henrides/bench_psu/kicad/sim/INA180A1 Test Circuit-PSpiceFiles/SCHEMATIC1/TRANSIENT/TRANSIENT.cir

** Profile: "SCHEMATIC1-TRANSIENT"  [ C:\Macromodels\PSpice Library\^INA180\INA180A1_PSpice\ina180a1 test circuit-pspicefiles\schematic1\transient.sim ] 

** Creating circuit file "TRANSIENT.cir" 
** WARNING: THIS AUTOMATICALLY GENERATED FILE MAY BE OVERWRITTEN BY SUBSEQUENT SIMULATIONS

*Libraries: 
* Profile Libraries :
* Local Libraries :
.LIB "../../../ina180a1.lib" 
* From [PSPICE NETLIST] section of C:\Users\a0282827\AppData\Roaming\SPB_Data\cdssetup\OrCAD_PSpice/16.6.0/PSpice.ini file:
.lib "nom.lib" 

*Analysis directives: 
.TRAN  0 300u 0 300n 
.OPTIONS ADVCONV
.PROBE64 V(alias(*)) I(alias(*)) W(alias(*)) D(alias(*)) NOISE(alias(*)) 
.INC "..\SCHEMATIC1.net" 


.END
