henrides/bench_psu/(list of files, drawings)

Other design files:
kicad/sim/INA180_PSPICE_AIO_16AUG2019.bak/INA180.DSN
kicad/sim/INA180_PSPICE_AIO_16AUG2019.bak/ina180.opj
kicad/sim/ina180a1 test circuit.dsn
kicad/sim/ina180a1 test circuit.opj
