henrides/bench_psu/kicad/Regulation/Regulation.kicad_pcb

## KiCad design kicad/Regulation/Regulation.kicad_pcb (2025-05-29)

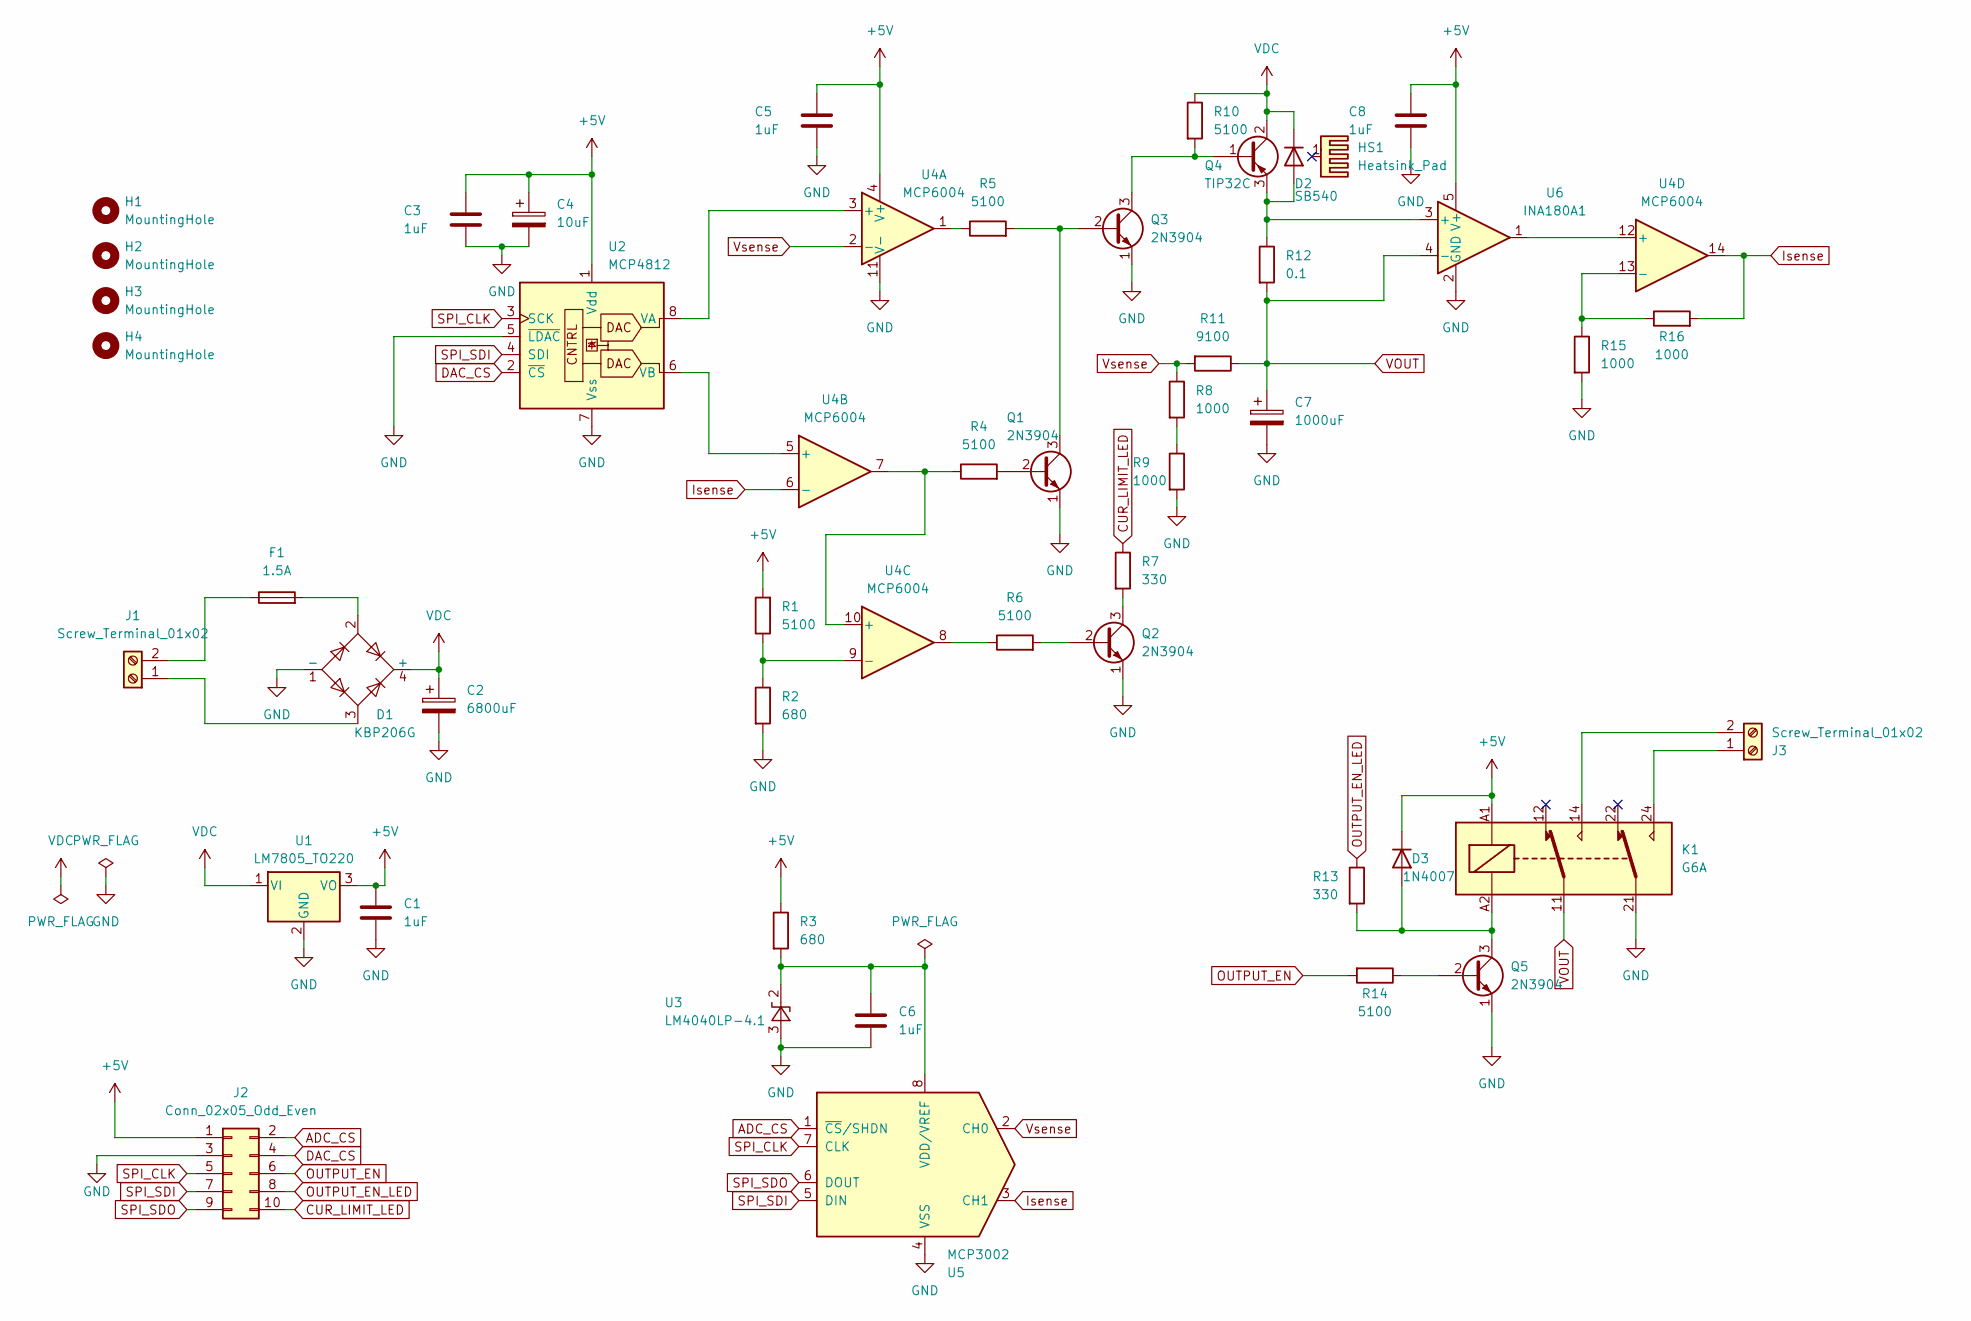
[picture p1: schematic Regulation.kicad_sch, PSU - Regulation]

Parts:
C1, C3, C5, C6, C8: 1uF; C_0805_2012Metric
C2: 6800uF; CP_Radial_D18.0mm_P7.50mm
C4: 10uF; CP_EIA-3216-18_Kemet-A_Pad1.58x1.35mm_HandSolder
C7: 1000uF; CP_Radial_D12.5mm_P5.00mm
D1: KBP206G; Diode_THT_Diode_Bridge_SIP365W86P406L1475H1060Q4
D2: SB540; D_DO-201AD_P12.70mm_Horizontal
D3: 1N4007; D_DO-41_SOD81_P7.62mm_Horizontal
F1: 1.5A; Fuseholder_Clip-6.3x32mm_Littelfuse_102_122_Inline_P34.21x7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
H1, H2, H3, H4: MountingHole; MountingHole_3.2mm_M3
HS1: Heatsink_Pad; Heatsink_Fischer_SK129-STS_42x25mm_2xDrill2.5mm
J1, J3: Screw_Terminal_01x02; TerminalBlock_RND_205-00012_1x02_P5.00mm_Horizontal
J2: Conn_02x05_Odd_Even; PinSocket_2x05_P2.54mm_Vertical
K1: G6A; Relay_DPDT_Omron_G6A
Q1, Q2, Q3, Q5: 2N3904; TO-92_Inline_Wide
Q4: TIP32C; TO-220-3_Vertical
R1, R4, R5, R6, R10, R14: 5100; R_0805_2012Metric
R2, R3: 680; R_0805_2012Metric
R7, R13: 330; R_0805_2012Metric
R8, R9, R15, R16: 1000; R_0805_2012Metric
R11: 9100; R_0805_2012Metric
R12: 0.1; R_Bare_Metal_Element_L16.3mm_W4.0mm_no_mask
U1: LM7805_TO220; TO-220-3_Vertical
U2: MCP4812; DIP-8_W7.62mm
U3: LM4040LP-4.1; TO-92_Inline
U4: MCP6004; DIP-14_W7.62mm
U5: MCP3002; DIP-8_W7.62mm
U6: INA180A1; SOT-23-5_HandSoldering

Connections:
+5V: C1.1, C3.1, C4.1, C5.1, C8.1, D3.1 (K), J2.1, K1.A1, R1.2, R3.1, U1.3 (VO), U2.1 (Vdd), U4.4 (V+), U6.5 (V+)
ADC_CS: J2.2, U5.1 (~CS/SHDN)
CUR_LIMIT_LED: J2.10, R7.1
DAC_CS: J2.4, U2.2 (~CS)
GND: C1.2, C2.2, C3.2, C4.2, C5.2, C6.2, C7.2, C8.2, D1.1 (-), J2.3, K1.21, Q1.1 (E), Q2.1 (E), Q3.1 (E), Q5.1 (E), R2.2, R9.2, R15.2, U1.2 (GND), U2.5 (~LDAC), U2.7 (Vss), U3.3 (A), U4.11 (V-), U5.4 (VSS), U6.2 (GND)
Isense: R16.2, U4.6 (-), U4.14, U5.3 (CH1)
unnamed: D1.2, F1.2
unnamed: D2.2 (A), Q4.3 (E), R12.1, U6.3 (+)
unnamed: D3.2 (A), K1.A2, Q5.3 (C), R13.2
unnamed: D1.3, J1.1
unnamed: F1.1, J1.2
unnamed: J3.1, K1.24
unnamed: J3.2, K1.14
unnamed: Q1.2 (B), R4.2
unnamed: Q1.3 (C), Q3.2 (B), R5.2
unnamed: Q2.2 (B), R6.2
unnamed: Q2.3 (C), R7.2
unnamed: Q3.3 (C), Q4.1 (B), R10.2
unnamed: Q5.2 (B), R14.1
unnamed: R5.1, U4.1
unnamed: R6.1, U4.8
unnamed: R8.2, R9.1
unnamed: U2.8 (VA), U4.3 (+)
unnamed: U2.6 (VB), U4.5 (+)
unnamed: C6.1, R3.2, U3.2 (K), U5.8 (VDD/VREF)
unnamed: R4.1, U4.7, U4.10 (+)
unnamed: R1.1, R2.1, U4.9 (-)
unnamed: U4.12 (+), U6.1
unnamed: R15.1, R16.1, U4.13 (-)
OUTPUT_EN: J2.6, R14.2
OUTPUT_EN_LED: J2.8, R13.1
SPI_CLK: J2.5, U2.3 (SCK), U5.7 (CLK)
SPI_SDI: J2.7, U2.4 (SDI), U5.5 (DIN)
SPI_SDO: J2.9, U5.6 (DOUT)
VDC: C2.1, D1.4 (+), D2.1 (K), Q4.2 (C), R10.1, U1.1 (VI)
VOUT: C7.1, K1.11, R11.1, R12.2, U6.4 (-)
Vsense: R8.1, R11.2, U4.2 (-), U5.2 (CH0)

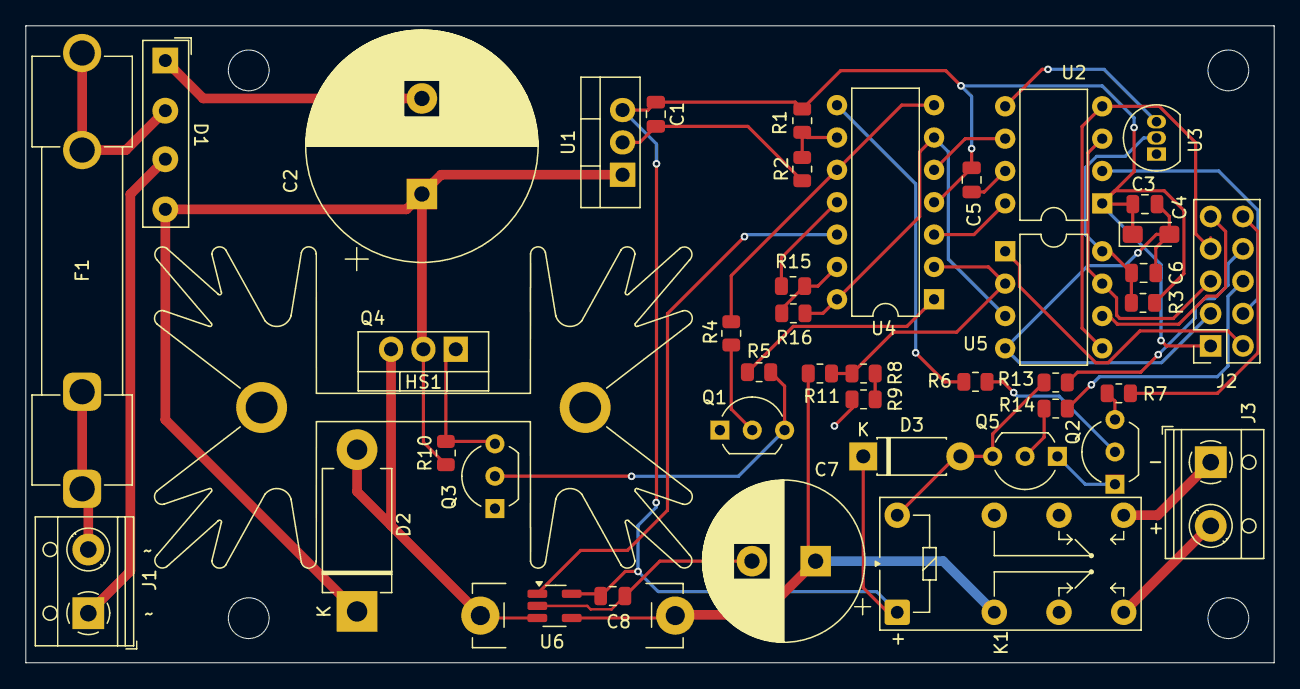
[picture p2: board Regulation.kicad_pcb from above]

Board: 2 copper layers, 98.0 x 50.0 mm, 48 parts (0 on the bottom side), 37 nets.
