henrides/bench_psu/kicad/Control/Control.kicad_pcb

## KiCad design kicad/Control/Control.kicad_pcb (2025-05-29)

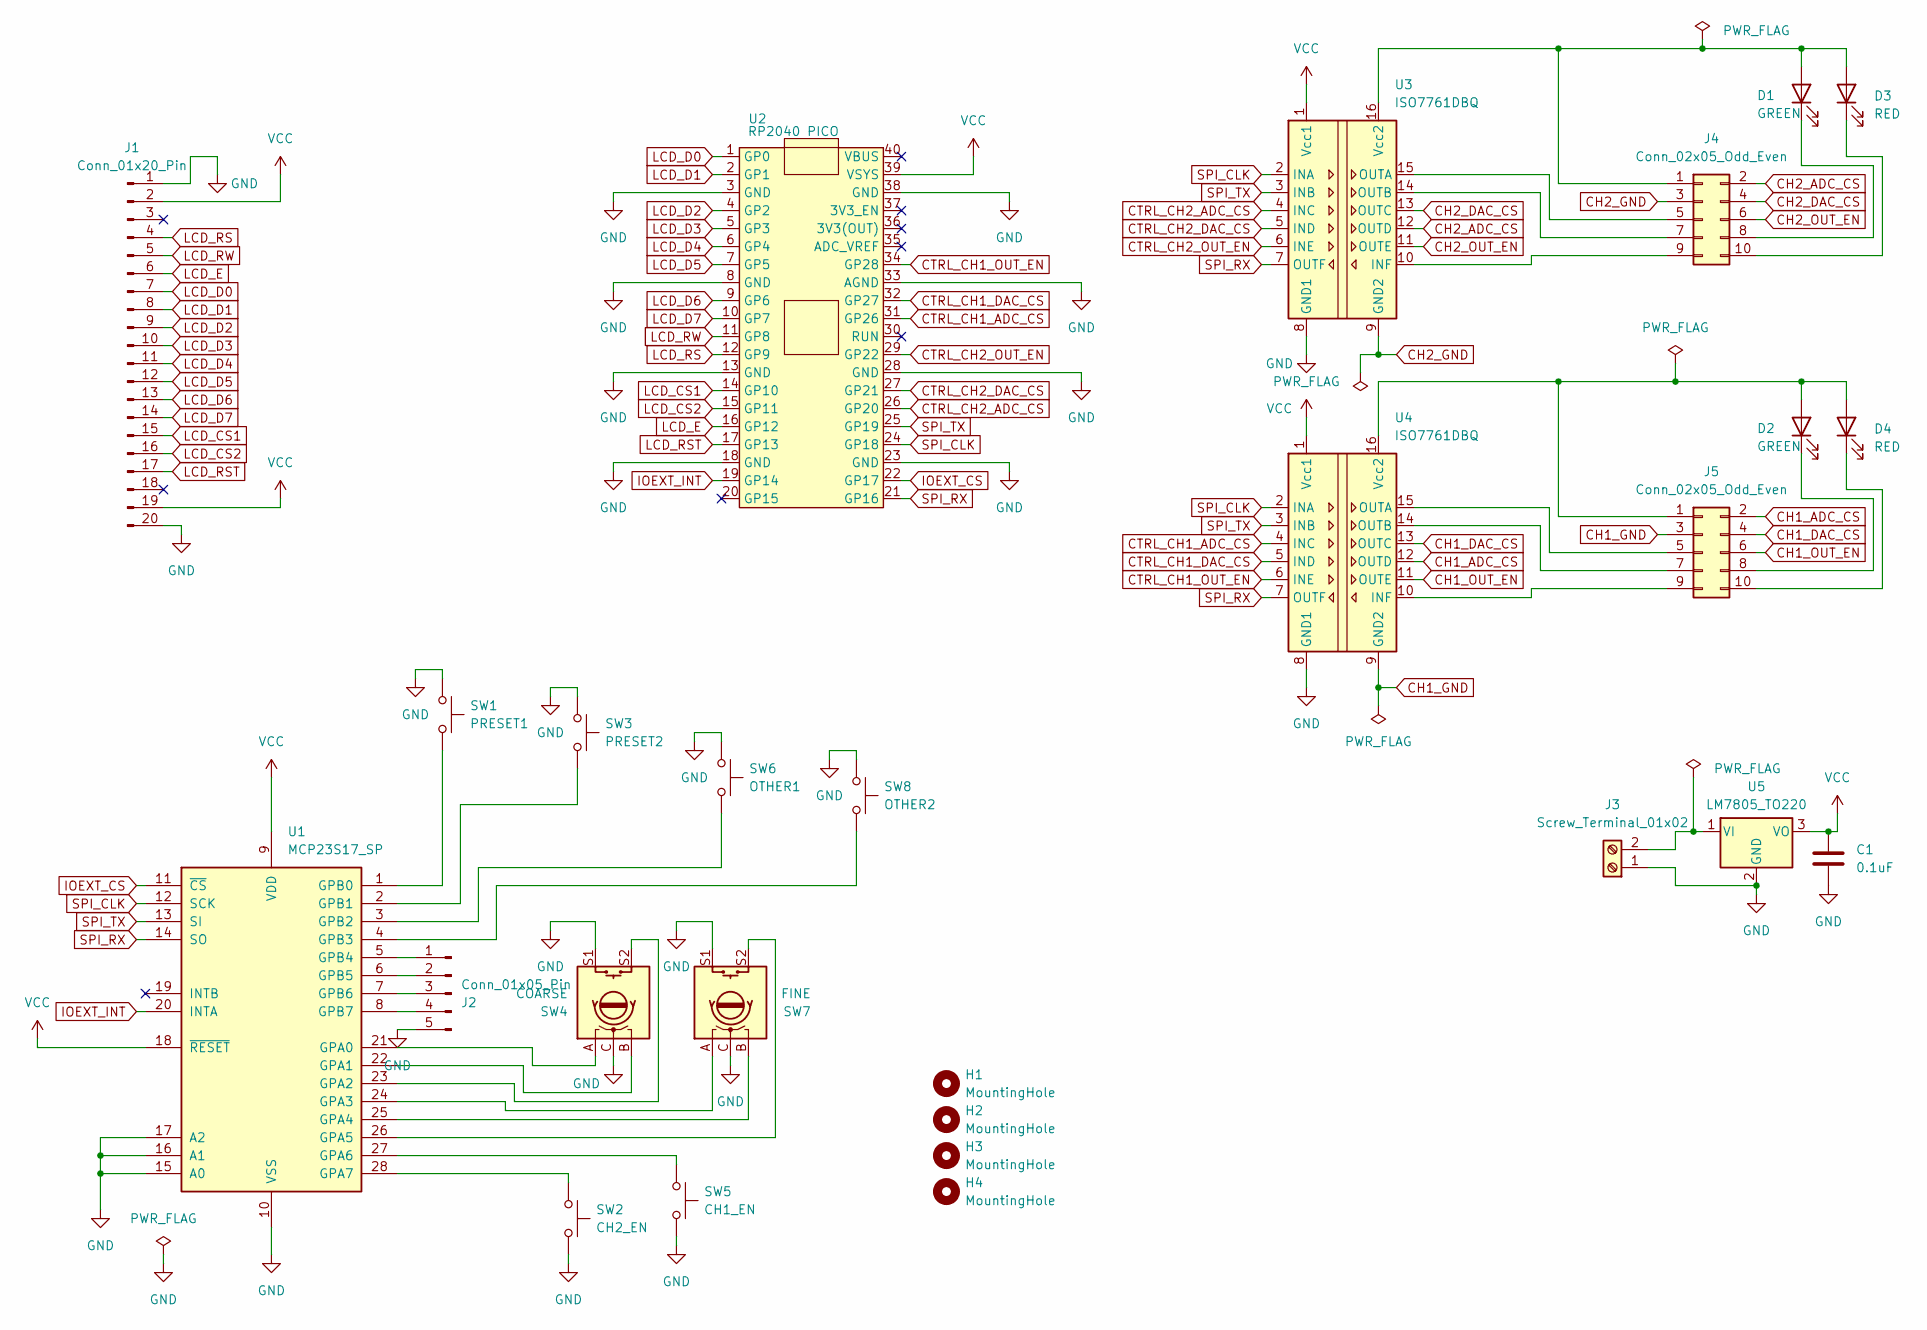
[picture p3: schematic Control.kicad_sch]

Parts:
C1: 0.1uF; C_0805_2012Metric
D1, D2: GREEN; LED_D5.0mm
D3, D4: RED; LED_D5.0mm
H1, H2, H3, H4: MountingHole; MountingHole_3.2mm_M3
J1: Conn_01x20_Pin; PinSocket_1x20_P2.54mm_Vertical
J2: Conn_01x05_Pin; PinHeader_1x05_P2.54mm_Vertical
J3: Screw_Terminal_01x02; TerminalBlock_RND_205-00012_1x02_P5.00mm_Horizontal
J4, J5: Conn_02x05_Odd_Even; Connector Header 2x05
SW1: PRESET1; SW_PUSH_6mm_H13mm
SW2: CH2_EN; SW_PUSH_6mm_H13mm
SW3: PRESET2; SW_PUSH_6mm_H13mm
SW4: COARSE; RotaryEncoder_Alps_EC11E-Switch_Vertical_H20mm_CircularMoun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
SW5: CH1_EN; SW_PUSH_6mm_H13mm
SW6: OTHER1; SW_PUSH_6mm_H13mm
SW7: FINE; RotaryEncoder_Alps_EC11E-Switch_Vertical_H20mm_CircularMoun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
SW8: OTHER2; SW_PUSH_6mm_H13mm
U1: MCP23S17_SP; DIP-28_W7.62mm
U2: RP2040 PICO; Raspberry_Pi_Pico_Headers
U3, U4: ISO7761DBQ; SSOP-16_3.9x4.9mm_P0.635mm
U5: LM7805_TO220; TO-220-3_Vertical

Connections:
CH1_ADC_CS: J5.2, U4.12 (OUTD)
CH1_DAC_CS: J5.4, U4.13 (OUTC)
CH1_GND: J5.3, U4.9 (GND2)
CH1_OUT_EN: J5.6, U4.11 (OUTE)
CH2_ADC_CS: J4.2, U3.12 (OUTD)
CH2_DAC_CS: J4.4, U3.13 (OUTC)
CH2_GND: J4.3, U3.9 (GND2)
CH2_OUT_EN: J4.6, U3.11 (OUTE)
CTRL_CH1_ADC_CS: U2.31 (GP26), U4.4 (INC)
CTRL_CH1_DAC_CS: U2.32 (GP27), U4.5 (IND)
CTRL_CH1_OUT_EN: U2.34 (GP28), U4.6 (INE)
CTRL_CH2_ADC_CS: U2.26 (GP20), U3.4 (INC)
CTRL_CH2_DAC_CS: U2.27 (GP21), U3.5 (IND)
CTRL_CH2_OUT_EN: U2.29 (GP22), U3.6 (INE)
GND: C1.2, J1.1, J1.20, J2.5, J3.1, SW1.1, SW2.2, SW3.1, SW4.C, SW4.S1, SW5.2, SW6.1, SW7.C, SW7.S1, SW8.1, U1.10 (VSS), U1.15 (A0), U1.16 (A1), U1.17 (A2), U2.3 (GND), U2.8 (GND), U2.13 (GND), U2.18 (GND), U2.23 (GND), U2.28 (GND), U2.33 (AGND), U2.38 (GND), U3.8 (GND1), U4.8 (GND1), U5.2 (GND)
IOEXT_CS: U1.11 (~CS), U2.22 (GP17)
IOEXT_INT: U1.20 (INTA), U2.19 (GP14)
LCD_CS1: J1.15, U2.14 (GP10)
LCD_CS2: J1.16, U2.15 (GP11)
LCD_D0: J1.7, U2.1 (GP0)
LCD_D1: J1.8, U2.2 (GP1)
LCD_D2: J1.9, U2.4 (GP2)
LCD_D3: J1.10, U2.5 (GP3)
LCD_D4: J1.11, U2.6 (GP4)
LCD_D5: J1.12, U2.7 (GP5)
LCD_D6: J1.13, U2.9 (GP6)
LCD_D7: J1.14, U2.10 (GP7)
LCD_E: J1.6, U2.16 (GP12)
LCD_RS: J1.4, U2.12 (GP9)
LCD_RST: J1.17, U2.17 (GP13)
LCD_RW: J1.5, U2.11 (GP8)
unnamed: D1.2 (A), D3.2 (A), J4.1, U3.16 (Vcc2)
unnamed: D1.1 (K), J4.8
unnamed: D2.2 (A), D4.2 (A), J5.1, U4.16 (Vcc2)
unnamed: D2.1 (K), J5.8
unnamed: D3.1 (K), J4.10
unnamed: D4.1 (K), J5.10
unnamed: J2.1, U1.5 (GPB4)
unnamed: J2.2, U1.6 (GPB5)
unnamed: J2.3, U1.7 (GPB6)
unnamed: J2.4, U1.8 (GPB7)
unnamed: J3.2, U5.1 (VI)
unnamed: J4.5, U3.15 (OUTA)
unnamed: J4.7, U3.14 (OUTB)
unnamed: J4.9, U3.10 (INF)
unnamed: J5.5, U4.15 (OUTA)
unnamed: J5.7, U4.14 (OUTB)
unnamed: J5.9, U4.10 (INF)
unnamed: SW4.A, U1.21 (GPA0)
unnamed: SW4.B, U1.22 (GPA1)
unnamed: SW4.S2, U1.23 (GPA2)
unnamed: SW7.A, U1.24 (GPA3)
unnamed: SW7.B, U1.25 (GPA4)
unnamed: SW7.S2, U1.26 (GPA5)
unnamed: SW5.1, U1.27 (GPA6)
unnamed: SW2.1, U1.28 (GPA7)
unnamed: SW1.2, U1.1 (GPB0)
unnamed: SW3.2, U1.2 (GPB1)
unnamed: SW6.2, U1.3 (GPB2)
unnamed: SW8.2, U1.4 (GPB3)
SPI_CLK: U1.12 (SCK), U2.24 (GP18), U3.2 (INA), U4.2 (INA)
SPI_RX: U1.14 (SO), U2.21 (GP16), U3.7 (OUTF), U4.7 (OUTF)
SPI_TX: U1.13 (SI), U2.25 (GP19), U3.3 (INB), U4.3 (INB)
VCC: C1.1, J1.2, J1.19, U1.9 (VDD), U1.18 (~RESET), U2.39 (VSYS), U3.1 (Vcc1), U4.1 (Vcc1), U5.3 (VO)

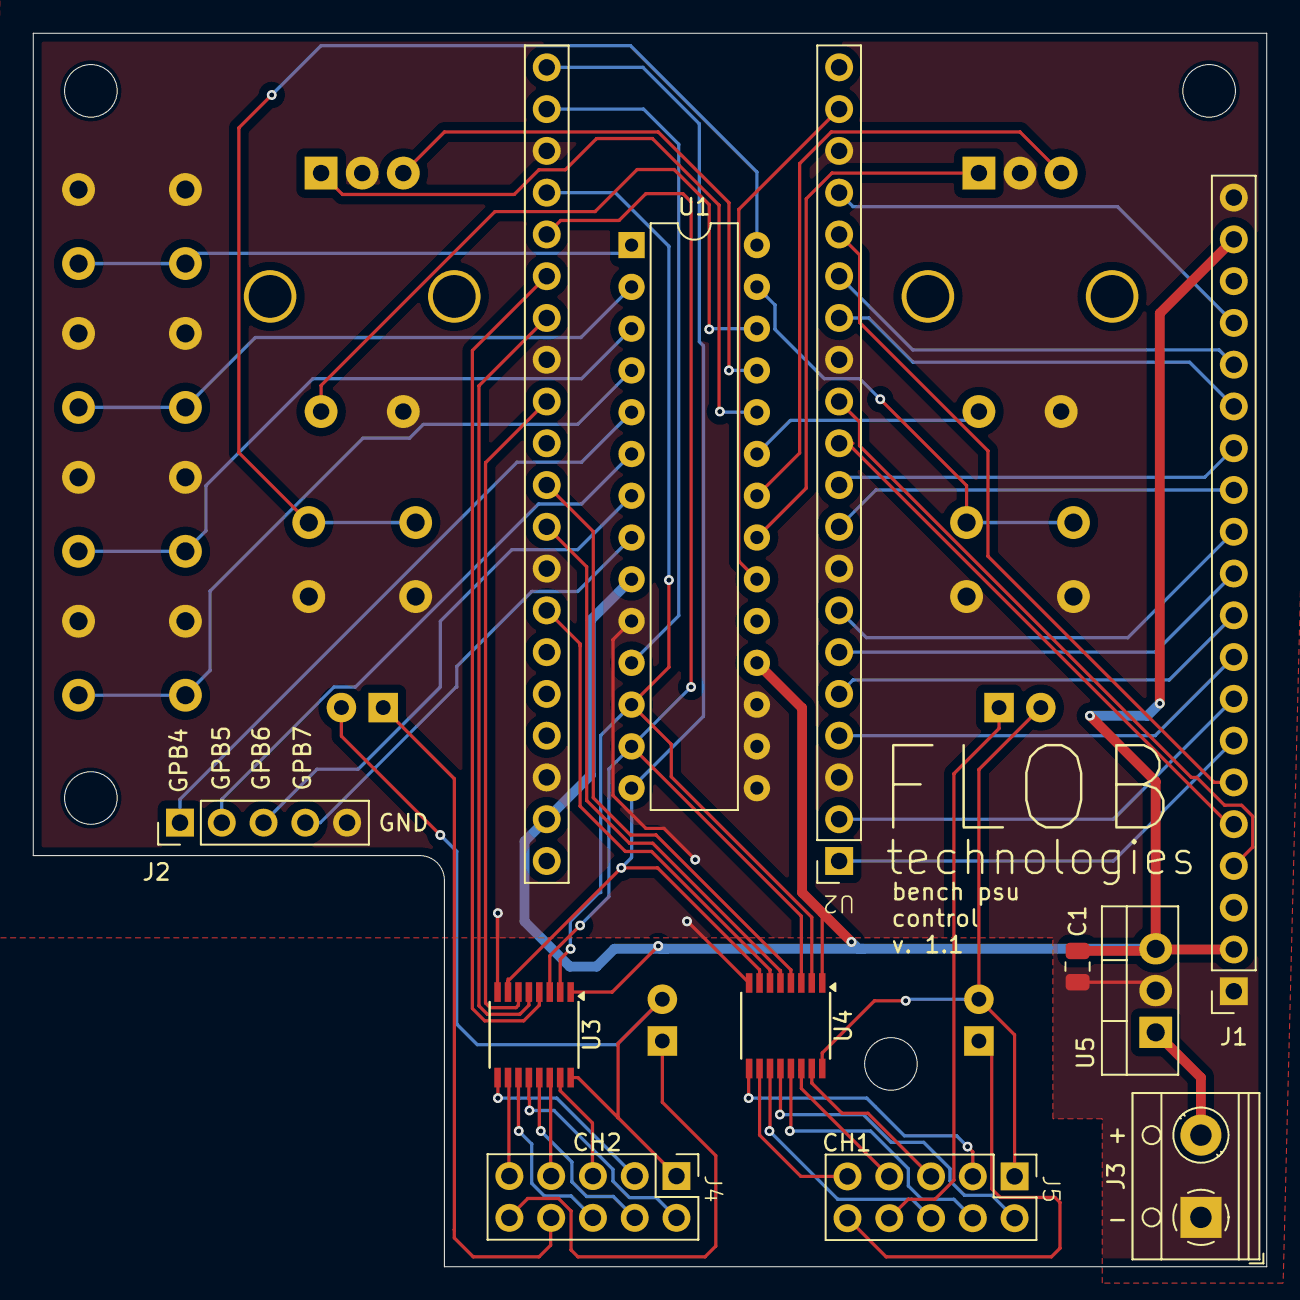
[picture p4: board Control.kicad_pcb from above]

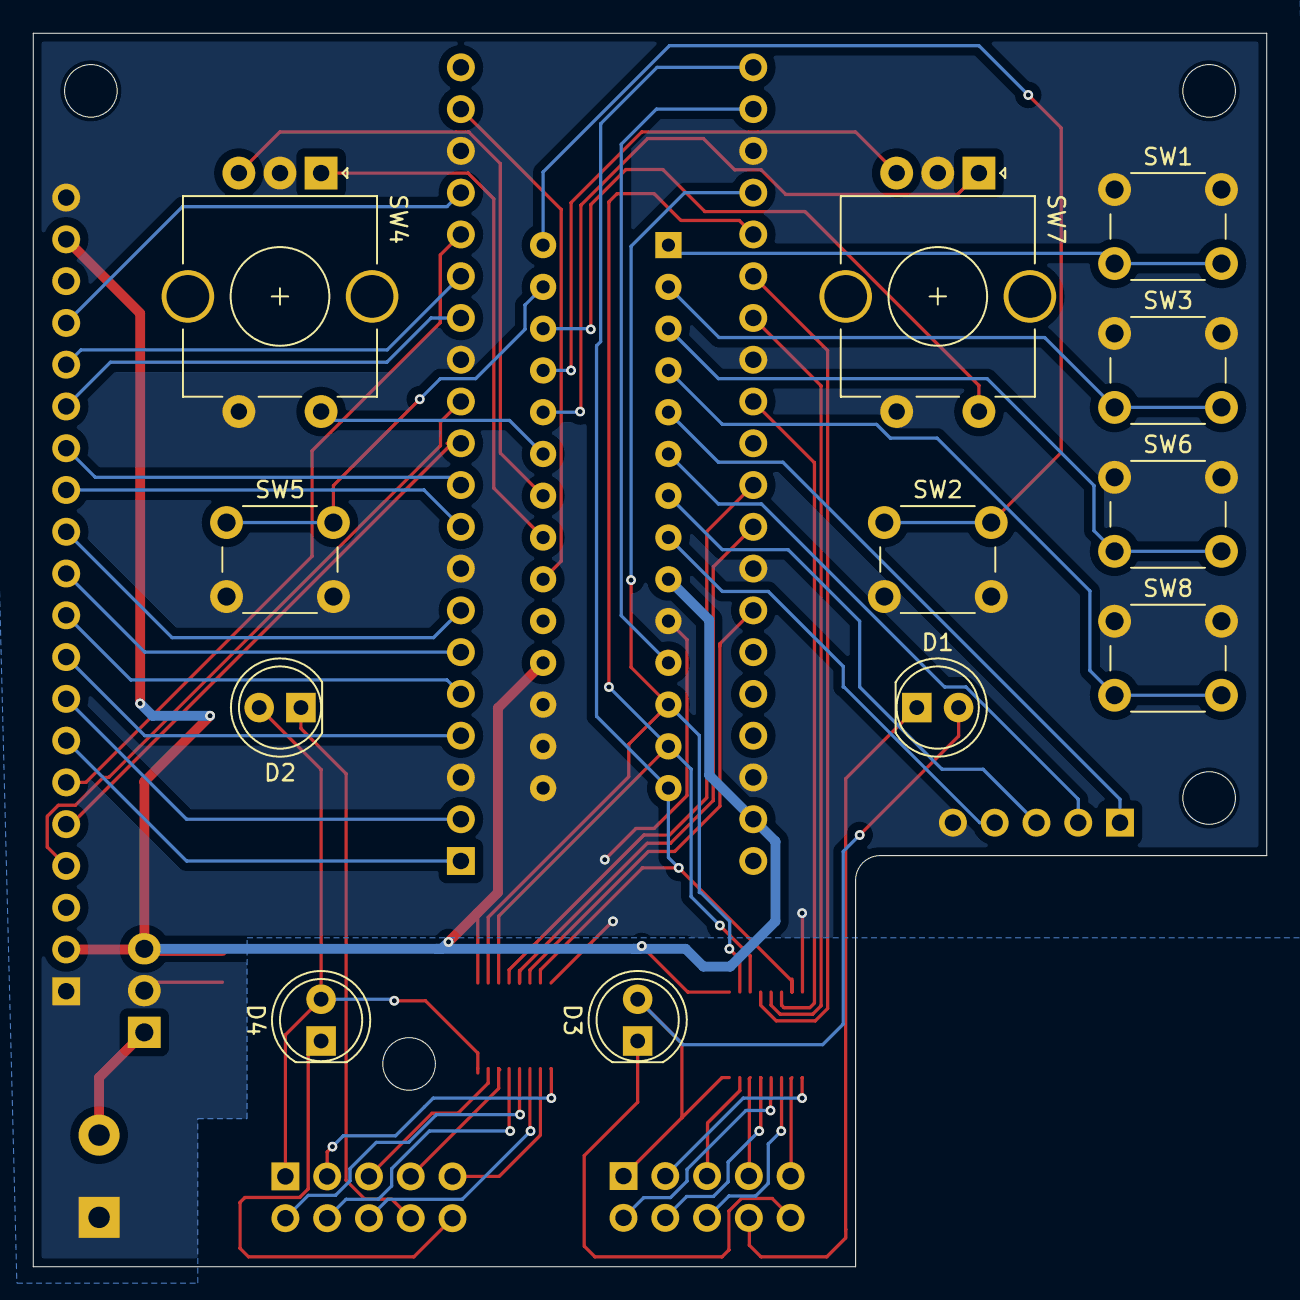
[picture p5: board Control.kicad_pcb from below]

Board: 2 copper layers, 75.0 x 75.0 mm, 27 parts (12 on the bottom side), 64 nets.
