henrides/bench_psu/(commit log)

2025-02-28 Integrate kicad models
    [Bench_PSU.kicad_pcb, Bench_PSU.kicad_sch, Control.kicad_pcb, Control.kicad_sch, INA180.DSN, Regulation.kicad_pcb, Regulation.kicad_sch, ina180.opj]
2025-05-29 Fix control connectors spacing
    [Control.kicad_pcb, Control.kicad_sch, Regulation.kicad_pcb]
